dyjin2/2021ASABE-Standard/README.md

# 2021ASABE-Standard
Best Electronic Presentation at the Standard Division: https://www.youtube.com/watch?v=dIZYb1IlLGQ&t=15s
# Hardware
Raspberry Pi + Arduino
